ProdYJ/Elab-car/BOM.xlsx

Composant | Valeur | Références | Quantité
Capa | 20pF | C1, C2 | 2
Capa | 10µF | C3,C6 | 2 | Note: remplacé par capa 22µF pour tests
Capa | 22µF | C4 | 1
Capa | 47µF | C5 | 1
Capa | 100nF | C7 | 1
Diodes Shottky |  | D1, D2, D3, D4, D5, D6, D7, D8, D9, D10, D16, D18, D20 | 13
WS2812b |  | D11, D12, D13, D14 | 4
led beue |  | D15, D17, D19 | 3
Fusible | 500mA | F1 | 1
USB B receptacle |  | J1 | 1
Screw terminal | 1x2 P5,08 | J2, J3, J4, J11, J12 | 5 | Essayer d'en choper au 2067 comme un gros shlag ?
pin header | 1x4 P2,54 | J5, J10 | 2
pin header | 1x3 P2,54 | J6, J7, J8 | 3
pin header | 1x8 | J9 | 1 | note : remplacé par 2 connecteurs 1x4 pour les tests
BJT | S8050 | Q1, Q2 | 2
Mosfet | 2N7000 | Q3, Q4 | 2
Resistor | 20R | R5 | 1
Resistor | 85R | R1, R6 | 2
Resistor | 12k | R2, R3, R4, R7, R8, R11, R12, R13 | 8
Bpush Button | 6x6x5 | Sw1, Sw2, Sw3 | 3
CH340g |  | U1 | 1
TP |  |  | 22
L293D |  | U2 | 1
AMS1777-3,3 |  | U3 | 1
esp32-wroom-32D |  | U4 | 1
L7805 |  | U5 | 1
Crystal | 12MHz | Y1 | 1
 |  |  | 86
