ProdYJ/Elab-car/to print.pdf

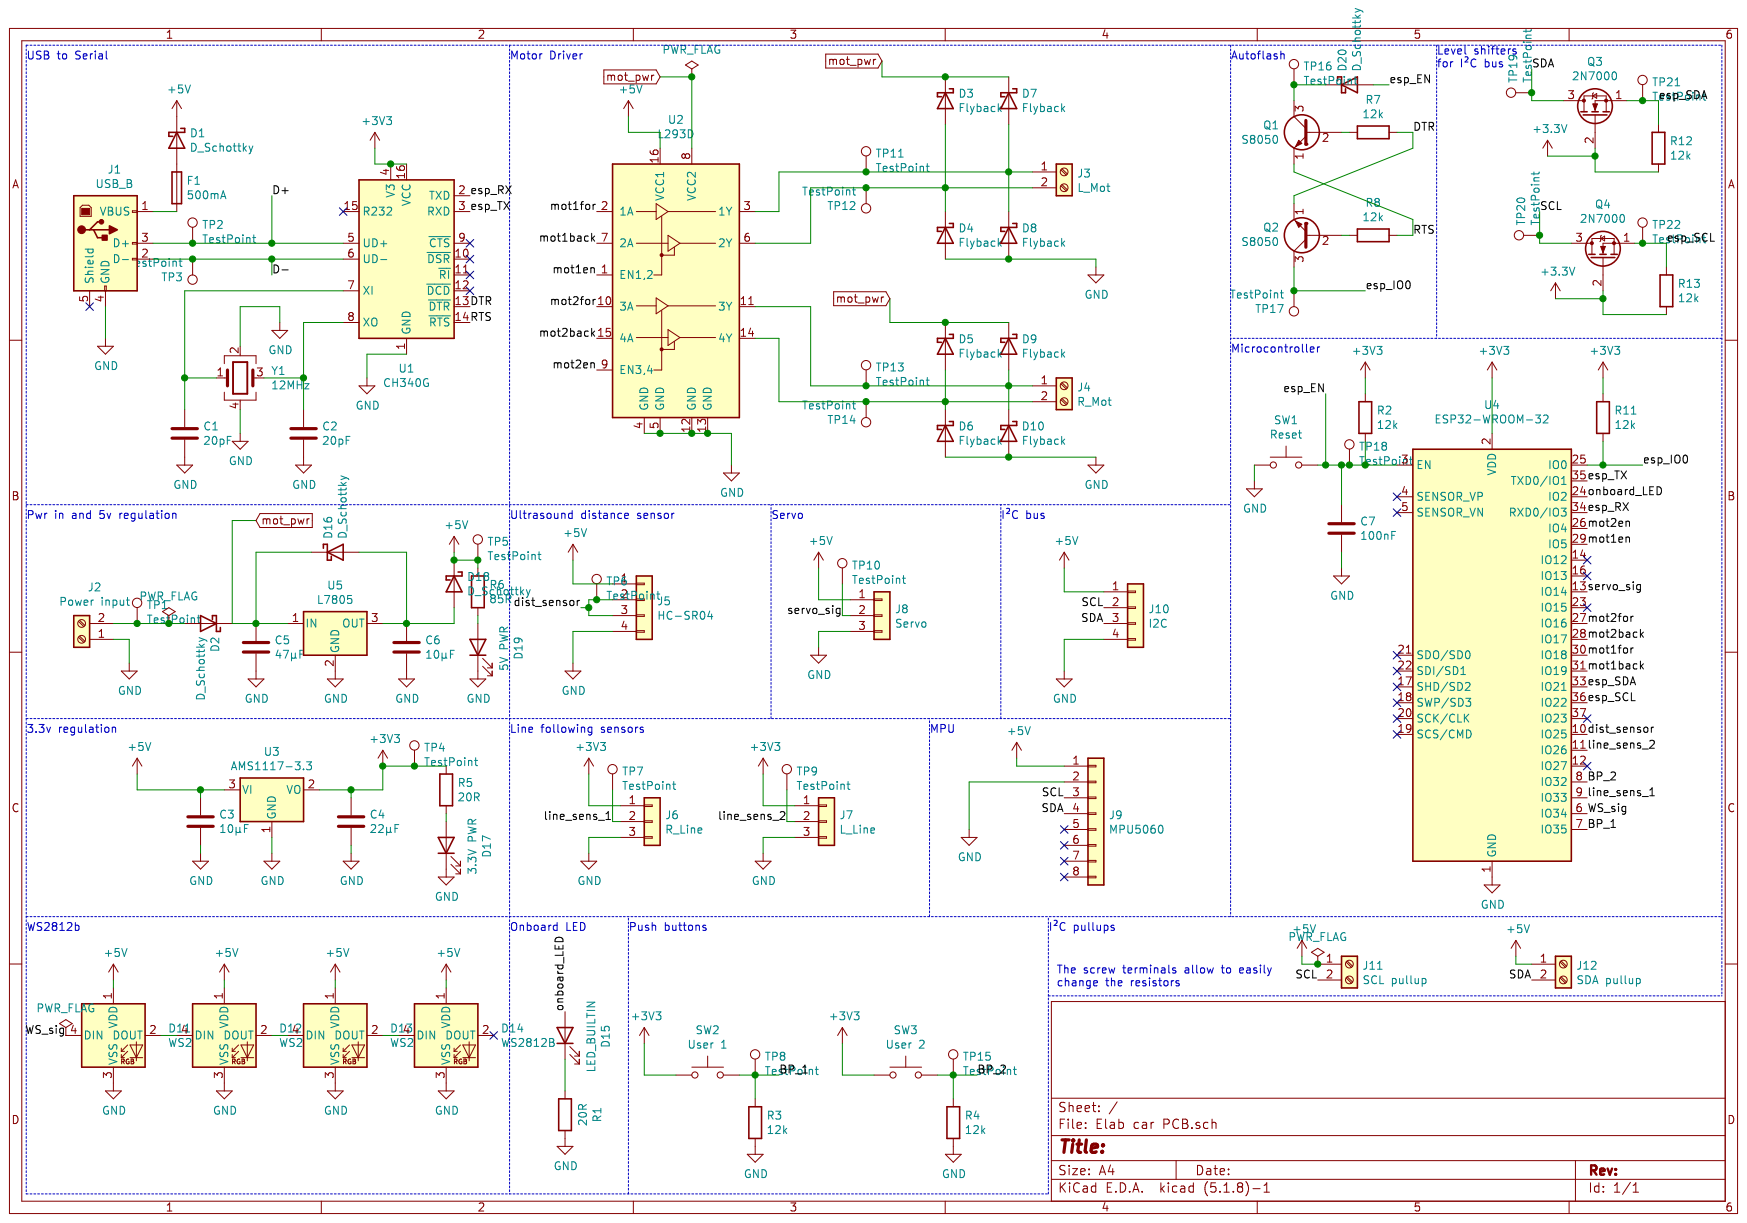
[picture p1: page 1]
