ProdYJ/Elab-car/Schema V3.pdf

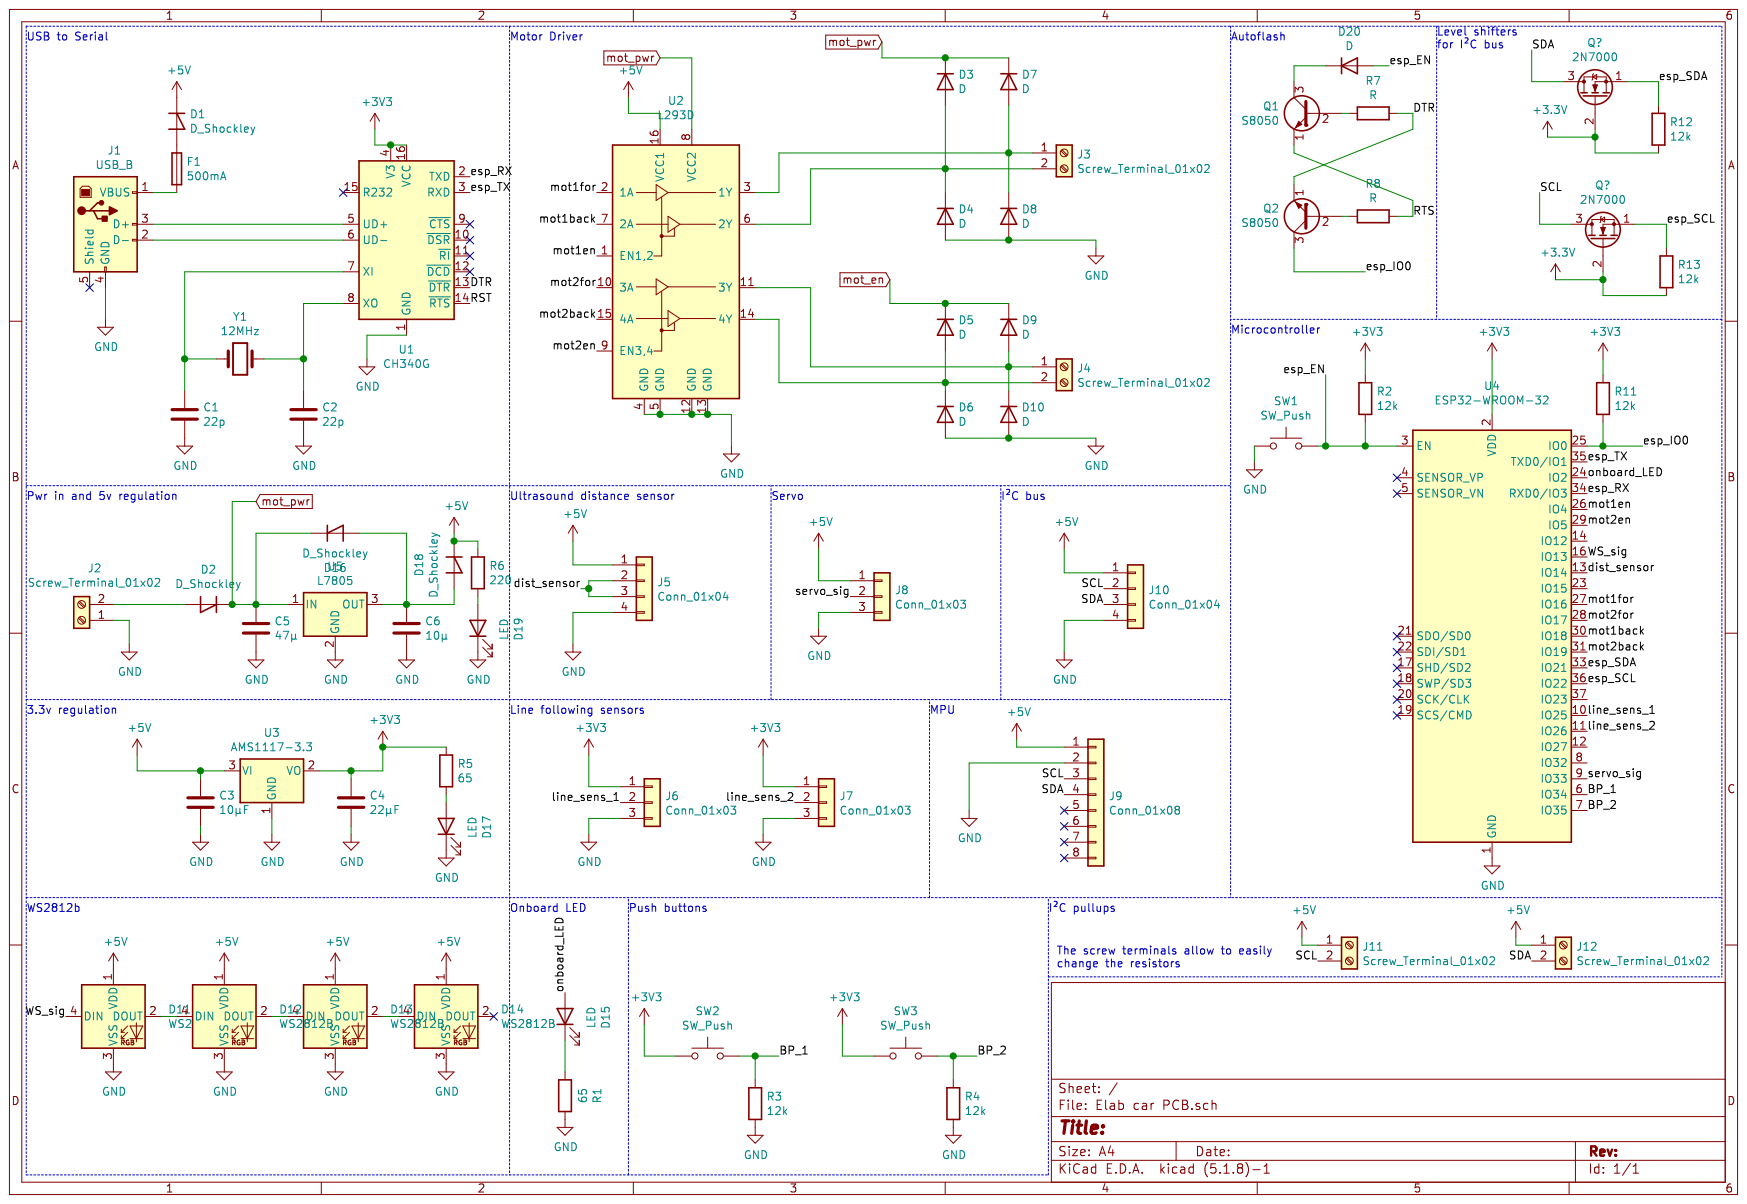
[picture p2: page 1]
