ProdYJ/Elab-car/Schema.pdf

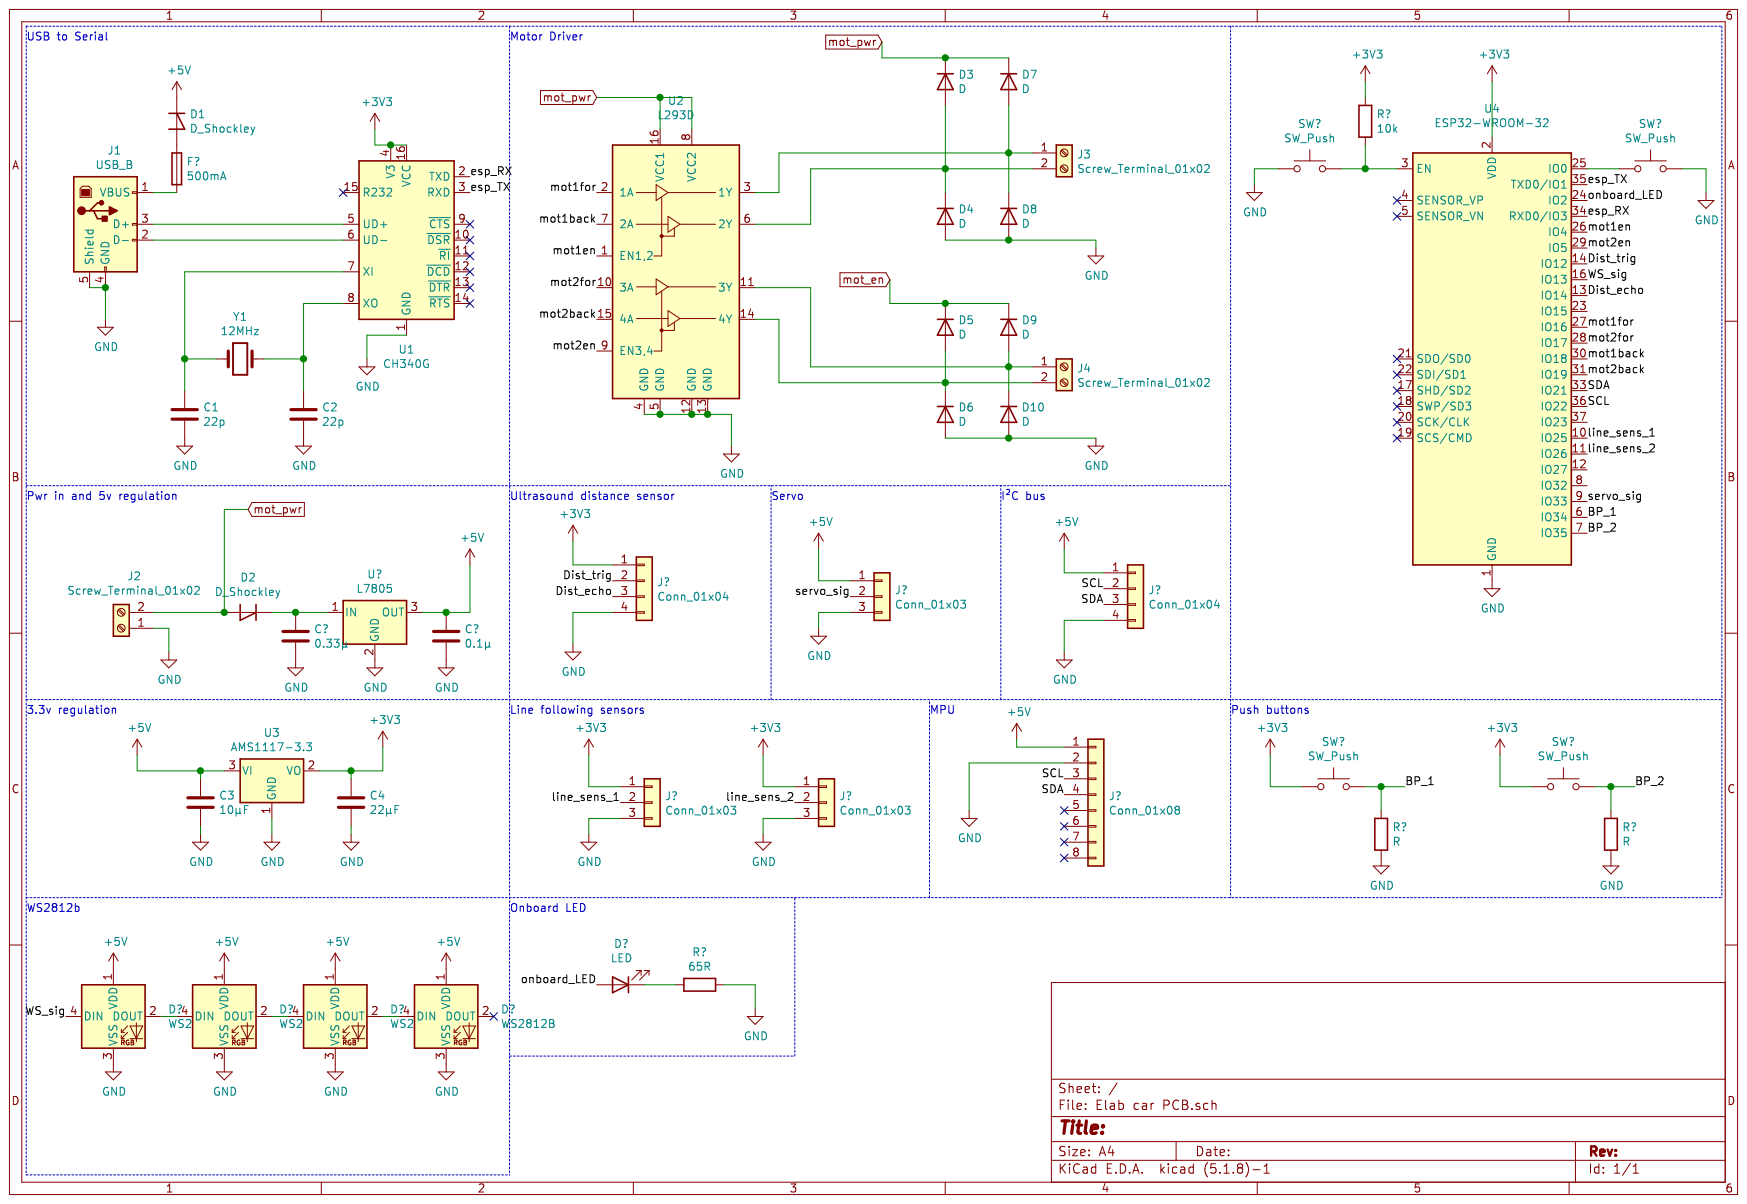
[picture p3: page 1]
