ProdYJ/Elab-car/Schema V2.pdf

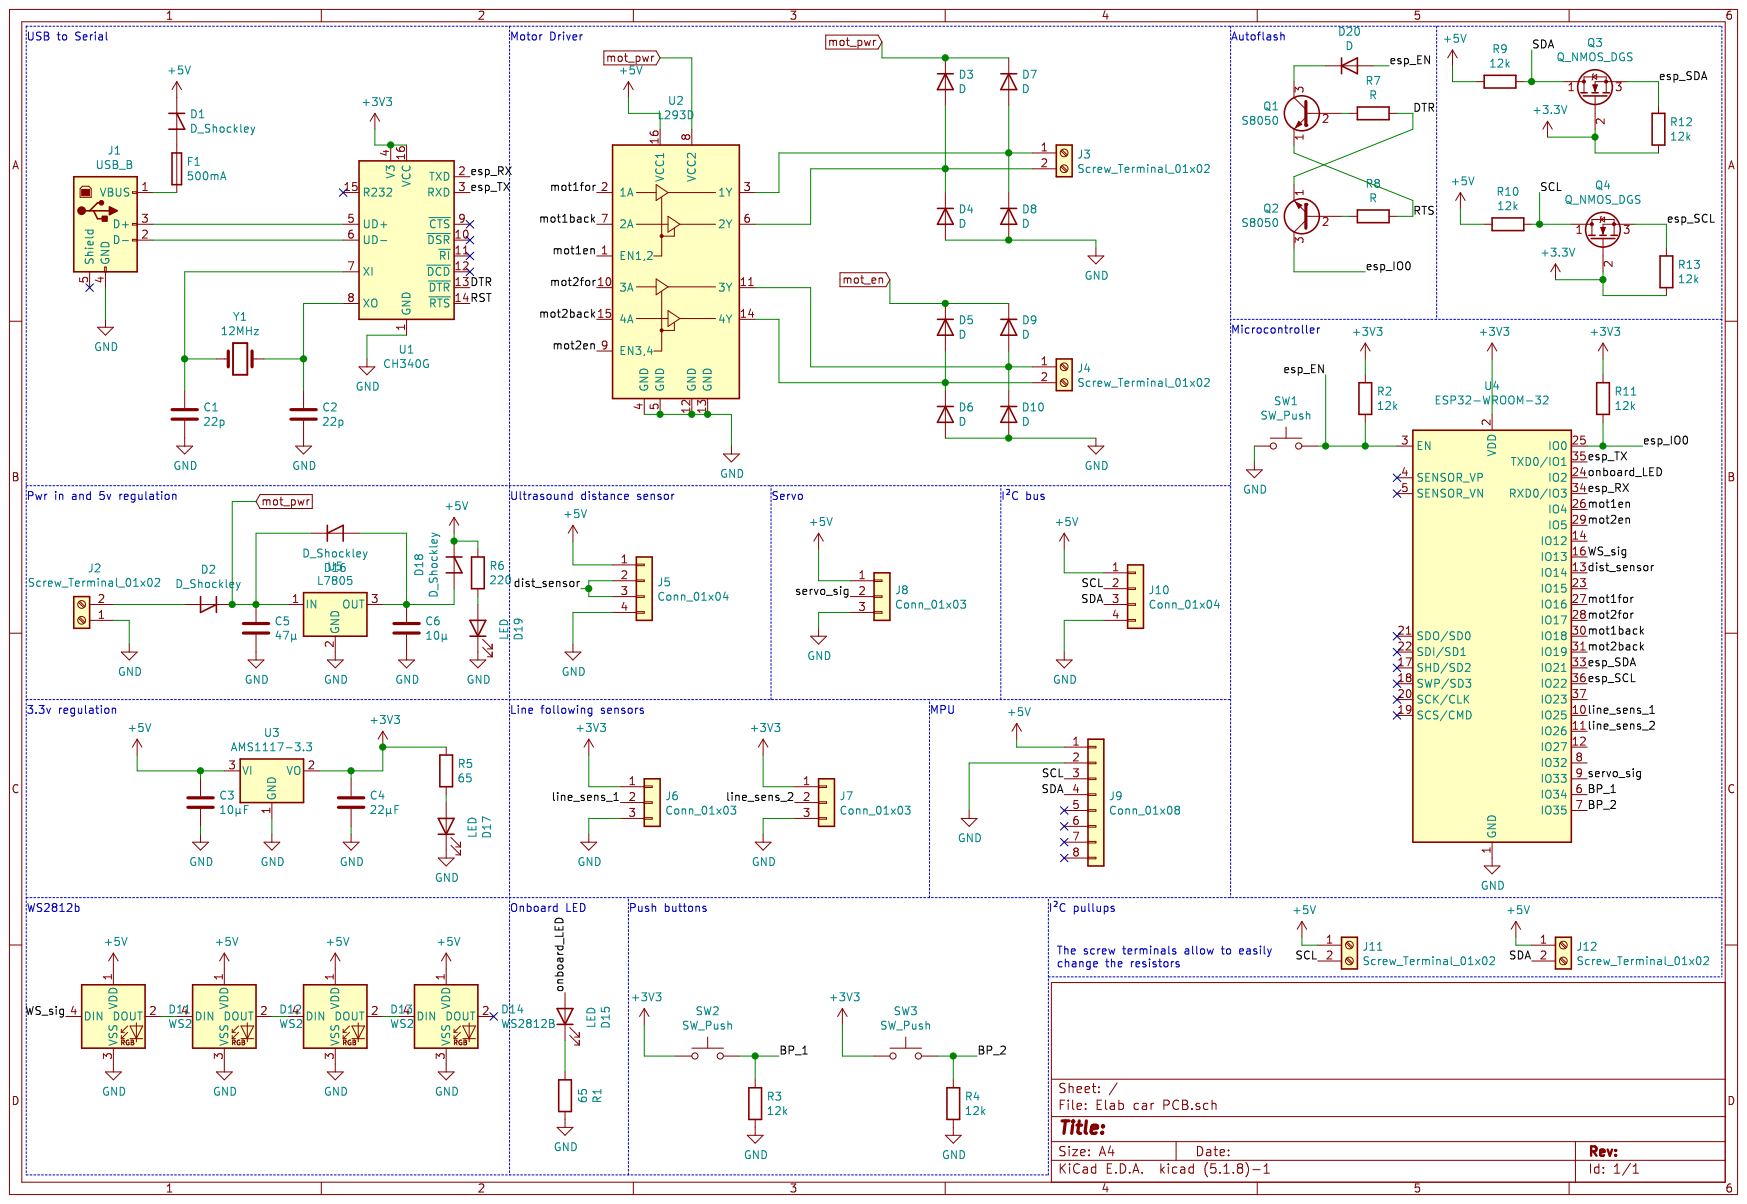
[picture p4: page 1]
