ProdYJ/Elab-car/Elab car PCB/Elab car PCB.kicad_pcb

## KiCad design Elab car PCB/Elab car PCB.kicad_pcb (2021-12-20)

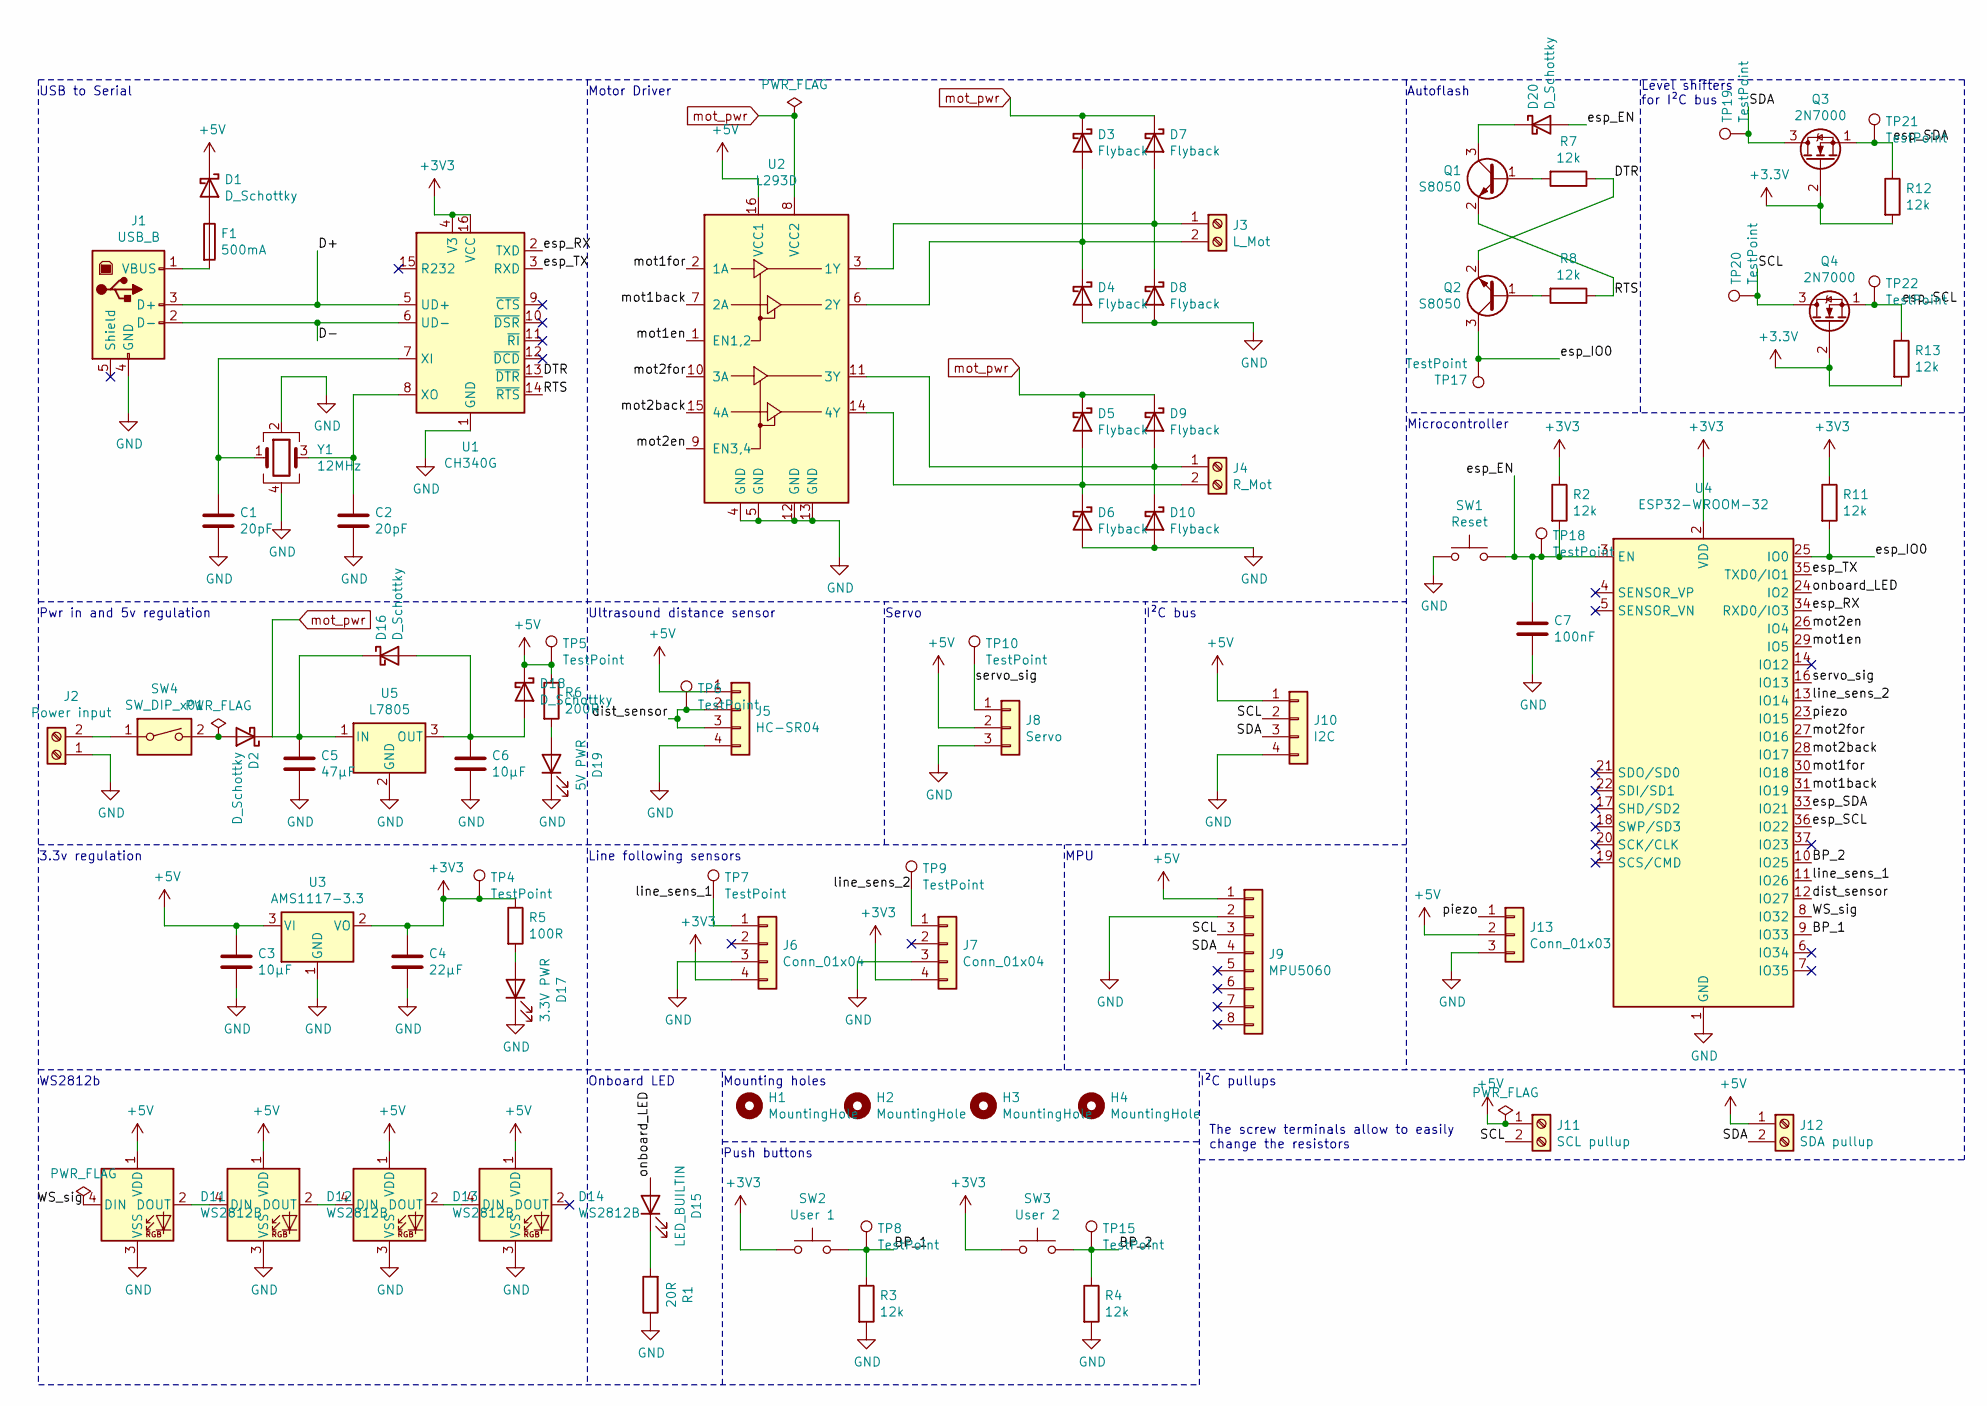
[picture p5: schematic Elab car PCB.sch]

Parts:
C1, C2: 20pF; C_1206_3216Metric_Pad1.33x1.80mm_HandSolder; LCSC # C1894
C3, C6: 10µF; CP_Elec_5x4.5; LCSC # C249788
C4: 22µF; CP_Elec_5x5.3; LCSC # C371125
C5: 47µF; CP_Elec_6.3x5.8; LCSC # C311639
C7: 100nF; C_1206_3216Metric_Pad1.33x1.80mm_HandSolder; LCSC # C107181
D1, D2, D16, D18, D20: D_Schottky; D_1206_3216Metric_Pad1.42x1.75mm_HandSolder; LCSC # C189958
D3, D4, D5, D6, D7, D8, D9, D10: Flyback; D_1206_3216Metric_Pad1.42x1.75mm_HandSolder; LCSC # C189958
D11, D12, D13, D14: WS2812B; LED_WS2812B_PLCC4_5.0x5.0mm_P3.2mm; LCSC # C114586
D15: LED_BUILTIN; LED_0805_2012Metric_Pad1.15x1.40mm_HandSolder; LCSC # C72035
D17: 3.3V PWR; LED_0805_2012Metric_Pad1.15x1.40mm_HandSolder; LCSC # C72035
D19: 5V PWR; LED_0805_2012Metric_Pad1.15x1.40mm_HandSolder; LCSC # C72035
F1: 500mA; Fuse_1206_3216Metric_Pad1.42x1.75mm_HandSolder; LCSC # C70070
H1, H2, H3, H4: MountingHole; MountingHole_3.2mm_M3_DIN965_Pad
J1: USB_B; USB_B_Lumberg_2411_02_Horizontal; LCSC # C397338
J2: Power input; TerminalBlock_bornier-2_P5.08mm; LCSC # C8465
J3: L_Mot; TerminalBlock_bornier-2_P5.08mm; LCSC # C8465
J4: R_Mot; TerminalBlock_bornier-2_P5.08mm; LCSC # C8465
J5: HC-SR04; PinHeader_1x04_P2.54mm_Vertical; LCSC # C124413
J6, J7: Conn_01x04; PinHeader_1x04_P2.54mm_Vertical
J8: Servo; PinHeader_1x03_P2.54mm_Vertical; LCSC # C225500
J9: MPU5060; PinHeader_1x08_P2.54mm_Vertical; LCSC # C27438
J10: I2C; PinHeader_1x04_P2.54mm_Vertical; LCSC # C124413
J11: SCL pullup; TerminalBlock_bornier-2_P5.08mm; LCSC # C8465
J12: SDA pullup; TerminalBlock_bornier-2_P5.08mm; LCSC # C8465
J13: Conn_01x03; PinHeader_1x03_P2.54mm_Vertical
Q1, Q2: S8050; SOT-23_Handsoldering
Q3, Q4: 2N7000; TO-92_Inline; LCSC # C9114
R1: 20R; R_1206_3216Metric_Pad1.30x1.75mm_HandSolder; LCSC # C25362
R2, R3, R4, R7, R8, R11, R12, R13: 12k; R_1206_3216Metric_Pad1.30x1.75mm_HandSolder; LCSC # C1491
R5: 100R; R_1206_3216Metric_Pad1.30x1.75mm_HandSolder; LCSC # C25362
R6: 200R; R_1206_3216Metric_Pad1.30x1.75mm_HandSolder; LCSC # C242479
SW1: Reset; SW_PUSH_6mm_H5mm; LCSC # C111373
SW2: User 1; SW_PUSH_6mm_H5mm; LCSC # C111373
SW3: User 2; SW_PUSH_6mm_H5mm; LCSC # C111373
SW4: SW_DIP_x01; SW_plugin8.5x8.5
TP4, TP5, TP6, TP7, TP8, TP9, TP10, TP15, TP17, TP18, TP19, TP20, TP21, TP22: TestPoint; TestPoint_Pad_D2.5mm
U1: CH340G; SOIC-16_3.9x9.9mm_P1.27mm; LCSC # C14267
U2: L293D; DIP-16_W7.62mm; LCSC # C12340
U3: AMS1117-3.3; SOT-223-3_TabPin2; LCSC # C369933
U4: ESP32-WROOM-32; LCSC # C473012
U5: L7805; TO-263-2; LCSC # C507146
Y1: 12MHz; Crystal_SMD_3225-4Pin_3.2x2.5mm_HandSoldering

Connections:
+5V: C3.1, D1.1 (K), D11.1 (VDD), D12.1 (VDD), D13.1 (VDD), D14.1 (VDD), D18.1 (K), J5.1, J8.2, J9.1, J10.1, J11.1, J12.1, J13.2, R6.1, TP5.1, U2.16 (VCC1), U3.3 (VI)
/BP_1: R3.1, SW2.2, TP8.1, U4.9 (IO33)
/BP_2: R4.1, SW3.2, TP15.1, U4.10 (IO25)
/D+: J1.3 (D+), U1.5 (UD+)
/D-: J1.2 (D-), U1.6 (UD-)
/DTR: Q2.2 (E), R7.1, U1.13 (~DTR)
/RTS: Q1.2 (E), R8.1, U1.14 (~RTS)
/SCL: J9.3, J10.2, J11.2, Q4.3 (D), TP20.1
/SDA: J9.4, J10.3, J12.2, Q3.3 (D), TP19.1
/WS_sig: D11.4 (DIN), U4.8 (IO32)
/dist_sensor: J5.2, J5.3, TP6.1, U4.12 (IO27)
/esp_EN: C7.1, D20.2 (A), R2.2, SW1.2, TP18.1, U4.3 (EN)
/esp_IO0: Q2.3 (C), R11.2, TP17.1, U4.25 (IO0)
/esp_RX: U1.2 (TXD), U4.34 (RXD0/IO3)
/esp_SCL: Q4.1 (S), R13.1, TP22.1, U4.36 (IO22)
/esp_SDA: Q3.1 (S), R12.1, TP21.1, U4.33 (IO21)
/esp_TX: U1.3 (RXD), U4.35 (TXD0/IO1)
/line_sens_1: J6.1, TP7.1, U4.11 (IO26)
/line_sens_2: J7.1, TP9.1, U4.13 (IO14)
/mot1back: U2.7 (2A), U4.31 (IO19)
/mot1en: U2.1 (EN1,2), U4.29 (IO5)
/mot1for: U2.2 (1A), U4.30 (IO18)
/mot2back: U2.15 (4A), U4.28 (IO17)
/mot2en: U2.9 (EN3,4), U4.26 (IO4)
/mot2for: U2.10 (3A), U4.27 (IO16)
/onboard_LED: D15.2 (A), U4.24 (IO2)
/piezo: J13.1, U4.23 (IO15)
/servo_sig: J8.1, TP10.1, U4.16 (IO13)
GND: C1.2, C2.2, C3.2, C4.2, C5.2, C6.2, C7.2, D4.2 (A), D6.2 (A), D8.2 (A), D10.2 (A), D11.3 (VSS), D12.3 (VSS), D13.3 (VSS), D14.3 (VSS), D17.1 (K), D19.1 (K), J1.4 (GND), J2.1, J5.4, J6.3, J7.3, J8.3, J9.2, J10.4, J13.3, R1.1, R3.2, R4.2, SW1.1, U1.1 (GND), U2.4 (GND), U2.5 (GND), U2.12 (GND), U2.13 (GND), U3.1 (GND), U4.1 (GND), U4.15 (GND), U4.38 (GND), U4.39 (GND), U5.2 (GND), Y1.2, Y1.4
unnamed: C1.1, U1.7 (XI), Y1.1
unnamed: C2.1, U1.8 (XO), Y1.3
unnamed: C6.1, D16.2 (A), D18.2 (A), U5.3 (OUT)
unnamed: D1.2 (A), F1.1
unnamed: D2.2 (A), SW4.2
unnamed: D3.2 (A), D4.1 (K), J3.2, U2.6 (2Y)
unnamed: D5.2 (A), D6.1 (K), J4.2, U2.14 (4Y)
unnamed: D7.2 (A), D8.1 (K), J3.1, U2.3 (1Y)
unnamed: D9.2 (A), D10.1 (K), J4.1, U2.11 (3Y)
unnamed: D11.2 (DOUT), D12.4 (DIN)
unnamed: D12.2 (DOUT), D13.4 (DIN)
unnamed: D13.2 (DOUT), D14.4 (DIN)
unnamed: D15.1 (K), R1.2
unnamed: D17.2 (A), R5.2
unnamed: D19.2 (A), R6.2
unnamed: D20.1 (K), Q1.3 (C)
unnamed: F1.2, J1.1 (VBUS)
unnamed: J2.2, SW4.1
unnamed: Q1.1 (B), R7.2
unnamed: Q2.1 (B), R8.2
mot_pwr: C5.1, D2.1 (K), D3.1 (K), D5.1 (K), D7.1 (K), D9.1 (K), D16.1 (K), U2.8 (VCC2), U5.1 (IN)

Notes on the sheet:
Ultrasound distance sensor
USB to Serial
Motor Driver
Pwr in and 5v regulation
3.3v regulation
WS2812b
Servo
I²C bus
Line following sensors
MPU
Onboard LED
Push buttons
I²C pullups
The screw terminals allow to easily change the resistors
Autoflash
Microcontroller
Level shifters for I²C bus
Mounting holes

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
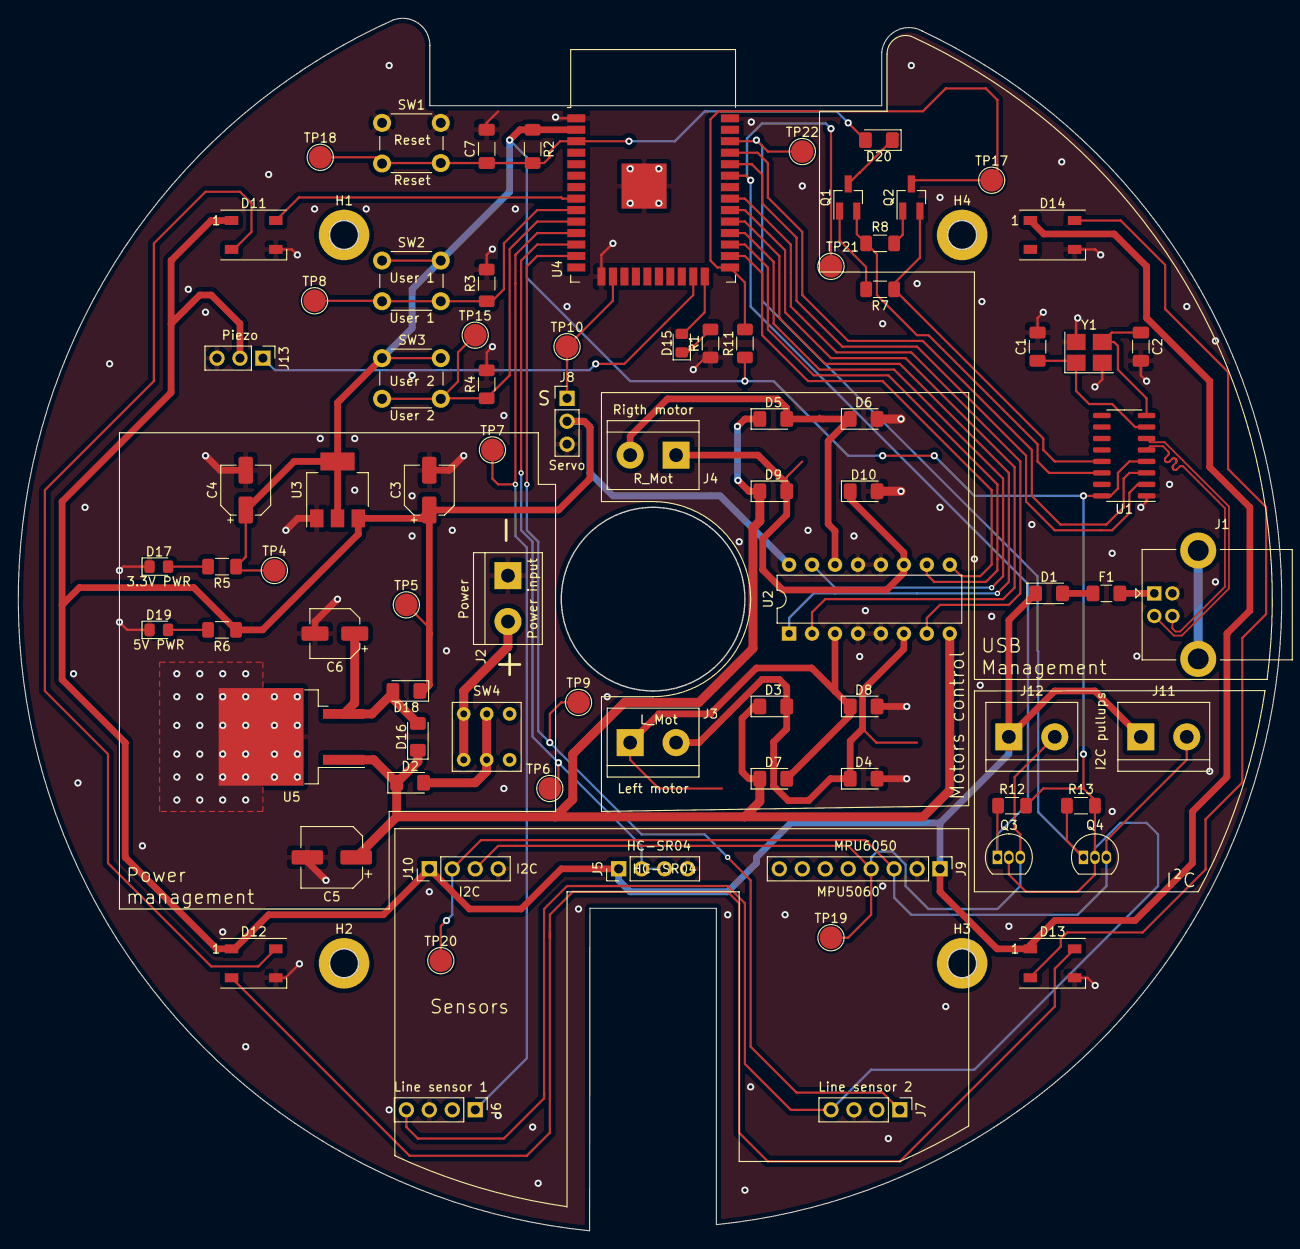
[picture p6: board Elab car PCB.kicad_pcb from above]

Board: 2 copper layers, 139.8 x 134.2 mm, 84 parts (0 on the bottom side), 51 nets.
