ProdYJ/Elab-car/(commit log)

2021-04-27 Assignation d'empreintes
    [Elab car PCB.kicad_pcb, Elab car PCB.sch]
2021-04-27 Ajout de références
    [Elab car PCB.sch]
2021-09-20 PCB creation
    [Elab car PCB.kicad_pcb, Elab car PCB.sch]
2021-09-21 Silk screen
    [Elab car PCB.kicad_pcb, Elab car PCB.sch]
2021-10-01 Esp32 design requirements corrections
    [BOM.xlsx, Elab car PCB.kicad_pcb, Elab car PCB.sch]
2021-10-02 Board edge adjustment
    [Elab car PCB.kicad_pcb]
2021-10-02 Front silk screen adjustment
    [Elab car PCB.kicad_pcb]
2021-10-02 Adding gnd vias
    [Elab car PCB.kicad_pcb]
2021-12-20 Little corrections of V1.1
    [Elab car PCB-B_Cu.gbl, Elab car PCB-B_Mask.gbs, Elab car PCB-B_Paste.gbp, Elab car PCB-B_SilkS.gbo, Elab car PCB-Edge_Cuts.gm1, Elab car PCB-F_Cu.gtl, Elab car PCB-F_Mask.gts, Elab car PCB-F_Paste.gtp]
